markwu123454/Harbinger/README.md

# Harbinger

Harbinger is a coil gun mounted on a differential turret.
