markwu123454/Harbinger/(list of files, cad)

Other CAD files:
cad/turret/0100-v01.SLDASM
cad/turret/0117-v01.SLDPRT
cad/turret/0120-v01.SLDPRT
cad/turret/0125-v01.SLDPRT
cad/turret/Mirror0101-v02.SLDPRT
cad/turret/0101-v02.SLDPRT
cad/turret/Mirror0124-v01.SLDPRT
cad/turret/0121-v01.SLDPRT
cad/turret/0124-v01.SLDPRT
cad/turret/0111-v01.SLDPRT
cad/turret/0109-v01.SLDPRT
cad/turret/0115-v01.SLDPRT
cad/turret/0107-v02.SLDPRT
cad/turret/0116-v01.SLDPRT
cad/turret/0102-v01.SLDPRT
cad/turret/0103-v01.SLDPRT
cad/turret/0105-v01.SLDPRT
cad/turret/0113-v01.SLDPRT
cad/turret/0110-v01.SLDPRT
cad/turret/0106-v01.SLDPRT
cad/turret/0123-v01.SLDPRT
cad/turret/0119-v01.SLDPRT
cad/turret/0114-v01.SLDPRT
cad/turret/0118-v01.SLDPRT
cad/turret/0122-v01.SLDPRT
cad/turret/0104-v02.SLDPRT
cad/turret/0112-v01.SLDPRT
cad/turret/0108-v01.SLDPRT
cad/COTS/220 35V Capacitor, LM2596 Buck Converter 4.0-40 to 1.3-37V.SLDPRT
cad/COTS/3 Digit 7 Segment Display, LM2596 Buck Converter 4.0-40 to 1.3-37V.SLDPRT
cad/COTS/AS5600.SLDPRT
cad/COTS/Base, LM2596 Buck Converter 4.0-40 to 1.3-37V.SLDPRT
cad/COTS/C14 Combo Socket (AC-14-F16).SLDPRT
cad/COTS/DG301-5.0-02, LM2596 Buck Converter 4.0-40 to 1.3-37V.SLDPRT
cad/COTS/EL90002--STD--Tomada de Força (Plug Tripolar Macho - C14 10A).SLDPRT
cad/COTS/ESP32-DEVKITC-32U--3DModel-STEP-418109.SLDPRT
cad/COTS/GM4108Motor_AS5048AEncoder_simplified.SLDPRT
cad/COTS/GM4108Motor_simplified.SLDPRT
cad/COTS/LM2596 Buck Converter 4.0-40 to 1.3-37V.SLDASM
cad/COTS/LRS-150.SLDPRT
cad/COTS/SKF_608-2ZZ.SLDPRT
cad/COTS/SimpleFOC Mini Driver.SLDPRT
cad/COTS/TCA9548.SLDPRT
cad/COTS/Trimpot 3296W, LM2596 Buck Converter 4.0-40 to 1.3-37V.SLDPRT
cad/COTS/diametric small magnet.SLDPRT
cad/COTS/slip ring.SLDPRT
cad/turret/0101-v01.SLDPRT
cad/turret/0104-v01.SLDPRT
cad/turret/0107-v01.SLDPRT
