markwu123454/Harbinger/src/SharedData.cpp

#include "SharedData.h"
#include <stdio.h>

SharedData        shared;
SemaphoreHandle_t dataMutex  = nullptr;
QueueHandle_t     logQueue   = nullptr;

void sharedInit() {
    dataMutex = xSemaphoreCreateMutex();
    logQueue  = xQueueCreate(LOG_QUEUE_DEPTH, sizeof(LogEntry));
}

// ── Log queue ─────────────────────────────────────────────────────

void logWrite(uint8_t level, const char* fmt, ...) {
    if (!logQueue) return;
    LogEntry e{};
    e.level = level;
    va_list args;
    va_start(args, fmt);
    vsnprintf(e.msg, sizeof(e.msg), fmt, args);
    va_end(args);
    // Non-blocking: drop the message if the queue is full rather than stalling a task
    xQueueSendToBack(logQueue, &e, 0);
}

bool logRead(LogEntry& out) {
    if (!logQueue) return false;
    return xQueueReceive(logQueue, &out, 0) == pdTRUE;
}

// ── Motor ↔ Shared ──────────────────────────────────────────────

MotorSnapshot motorRead() {
    MotorSnapshot s{};
    xSemaphoreTake(dataMutex, portMAX_DELAY);
    s.targetHeading   = shared.targetHeading;
    s.targetElevation = shared.targetElevation;
    s.turretArm       = shared.turretArm;
    s.masterArm       = shared.masterArm;
    s.fireRequested   = shared.fireRequested;
    s.gunArm          = shared.gunArm;
    xSemaphoreGive(dataMutex);
    return s;
}

void motorWrite(float heading, float elevation,
                float aVel, float aAcc,
                float bVel, float bAcc) {
    xSemaphoreTake(dataMutex, portMAX_DELAY);
    shared.currentHeading   = heading;
    shared.currentElevation = elevation;
    shared.motorA_vel       = aVel;
    shared.motorA_acc       = aAcc;
    shared.motorB_vel       = bVel;
    shared.motorB_acc       = bAcc;
    shared.fireRequested    = false;
    xSemaphoreGive(dataMutex);
}

void motorSetCalibrated(bool cal) {
    xSemaphoreTake(dataMutex, portMAX_DELAY);
    shared.calibrated = cal;
    xSemaphoreGive(dataMutex);
}

// ── Wifi ↔ Shared ───────────────────────────────────────────────

WifiSnapshot wifiRead() {
    WifiSnapshot s{};
    xSemaphoreTake(dataMutex, portMAX_DELAY);
    s.currentHeading   = shared.currentHeading;
    s.currentElevation = shared.currentElevation;
    s.motorA_vel       = shared.motorA_vel;
    s.motorA_acc       = shared.motorA_acc;
    s.motorB_vel       = shared.motorB_vel;
    s.motorB_acc       = shared.motorB_acc;
    s.masterArm        = shared.masterArm;
    s.turretArm        = shared.turretArm;
    s.gunArm           = shared.gunArm;
    s.targetVoltage    = shared.targetVoltage;
    s.calibrated       = shared.calibrated;
    s.stateChanged     = shared.stateChanged;
    shared.stateChanged = false;
    xSemaphoreGive(dataMutex);
    return s;
}

void wifiWriteAim(float heading, float elevation) {
    xSemaphoreTake(dataMutex, portMAX_DELAY);
    shared.targetHeading   = heading;
    shared.targetElevation = elevation;
    xSemaphoreGive(dataMutex);
}

void wifiWriteArm(int masterArm, int turretArm, int gunArm) {
    xSemaphoreTake(dataMutex, portMAX_DELAY);
    bool changed = false;
    if (masterArm >= 0 && shared.masterArm != (bool)masterArm) { shared.masterArm = masterArm; changed = true; }
    if (turretArm >= 0 && shared.turretArm != (bool)turretArm) { shared.turretArm = turretArm; changed = true; }
    if (gunArm    >= 0 && shared.gunArm    != (bool)gunArm)    { shared.gunArm    = gunArm;    changed = true; }
    if (masterArm == 0 && (shared.turretArm || shared.gunArm)) {
        shared.turretArm = false;
        shared.gunArm    = false;
        changed = true;
    }
    if (changed) shared.stateChanged = true;
    xSemaphoreGive(dataMutex);
}

void wifiWriteVoltage(float v) {
    xSemaphoreTake(dataMutex, portMAX_DELAY);
    shared.targetVoltage = v;
    shared.stateChanged  = true;
    xSemaphoreGive(dataMutex);
}

void wifiWriteFire() {
    xSemaphoreTake(dataMutex, portMAX_DELAY);
    if (shared.gunArm && shared.masterArm)
        shared.fireRequested = true;
    xSemaphoreGive(dataMutex);
}
