markwu123454/Harbinger/(commit log)

2026-04-08 added cad
    [0100-v01.SLDASM, 0101-v01.SLDPRT, 0101-v02.SLDPRT, 0102-v01.SLDPRT, 0103-v01.SLDPRT, 0104-v01.SLDPRT, 0104-v02.SLDPRT, 0105-v01.SLDPRT]
2026-04-08 added electronics mount
    [0100-v01.SLDASM, 0120-v01.SLDPRT, 0121-v01.SLDPRT, TCA9548.SLDPRT]
2026-05-02 Replace WiFi/WebSocket with Bluetooth Classic SPP + binary framed protocol
    Removes the soft-AP hotspot, HTTP server, DNS captive portal, and WebSocket
    in favour of BluetoothSerial (RFCOMM/SPP) on the ESP32. Replaces JSON text
    frames with a tight binary protocol—one type byte followed by a fixed-size
    packed payload—eliminating JSON parsing overhead and cutting per-frame size
    to 1–25 bytes for the high-rate messages.
    New files
    include/proto.h — canonical C++ protocol: type IDs, payload sizes,
    packed structs (PktAim, PktState, PktTelemetry …),
    ARM 2-bit encoding helpers, STATE flag constants.
    include/BtTask.h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
    [BtTask.h, Config.h, main.cpp, proto.h]
2026-05-03 feat: add AS5600 closed-loop position control
    - Add CLOSED_LOOP_POSITION mode using MagneticSensorI2C (SimpleFOC)
    - Init two separate I2C buses so both AS5600s (fixed addr 0x36) coexist
    - Link sensors to motors before initFOC() for auto-calibration
    - applyPIDConfig() wires angle_P / velocity PID / LPF from TurretConfig
    - Add encoder I2C pin fields to TurretPins (sdaA/sclA on bus0, sdaB/sclB on bus1)
    - Add PID gain fields to TurretConfig with tunable defaults
    - controlTask switches to CLOSED_LOOP_POSITION by default
    [Config.h, DifferentialTurret.cpp, DifferentialTurret.h]
2026-05-03 refactor: replace dual I2C buses with TCA9548A multiplexer for AS5600 encoders
    Both AS5600s share address 0x36 and now live on a single I2C bus behind
    a TCA9548A mux. MuxedMagneticSensorI2C selects the right channel before
    every getSensorAngle() call, so SimpleFOC needs no other changes.
    [Config.h, DifferentialTurret.cpp, DifferentialTurret.h, MuxedMagneticSensor.h, TCA9548A.h]
2026-05-09 Always track sensors + send full state dump on connect
    - DifferentialTurret::begin(): explicitly call motor.enable() after initFOC()
    so motor.enabled stays true permanently. DifferentialTurret::disable() only
    kills the driver hardware (no current), leaving loopFOC() running so the
    AS5600 sensors are always read — manual spinning while disarmed is now tracked.
    - BtTask: on client connect, send MSG_TELEMETRY immediately after MSG_STATE so
    the app gets current position/vel/accel without waiting for the first heartbeat.
    - Telemetry interval: 250ms → 50ms (20 Hz) for smoother live tracking.
2026-05-09 Bump telemetry to 100 Hz; batch type+payload into single BT write
    - Telemetry interval: 50ms -> 10ms (100 Hz), matching the control loop rate.
    Sending faster than 10ms would just re-transmit stale sensor values since
    motorWrite() only runs every 10ms in the control task.
    - sendRaw(): coalesce type byte and payload into a single bt_.write() call.
    At 100 Hz (200 write() calls/sec previously), the double round-trip through
    BluetoothSerial's TX queue added unnecessary overhead.
2026-05-09 Add MSG_LOG: remote string logging from any firmware task
    - proto.h: MSG_LOG=0x85, LOG_INFO/WARN/ERROR levels, PSIZ_LOG_HEADER=2
    - SharedData: FreeRTOS queue (depth 8) + logWrite(level, fmt, ...) / logRead()
    so ControlTask, DifferentialTurret, etc. can post messages without touching BT
    - BtTask: drain log queue immediately on connect (captures startup/initFOC logs)
    and on every subsequent loop iteration
    - DifferentialTurret::begin(): log initFOC() return value and post-calibration
    shaft_angle for both motors — dead/misread encoders show up immediately
    [BtTask.h, DifferentialTurret.cpp, SharedData.cpp, SharedData.h, proto.h]
2026-05-22 Fix encoder error messages never reaching the app
    setup() manually created dataMutex but never called sharedInit(), so
    logQueue remained nullptr. Every logWrite() guards with
    if (!logQueue) return, silently dropping all encoder init errors
    (sensor angle 0.0 warnings, initFOC failure errors) before they could
    be queued and forwarded to the app via MSG_LOG.
    Replace manual xSemaphoreCreateMutex() with sharedInit(), which
    creates both dataMutex and logQueue as documented in SharedData.h.
    https://claude.ai/code/session_01FsLupdy2irwsaDZRn6RpLY
    [main.cpp]
2026-05-22 Fix initFOC failure by setting voltage_sensor_align
    initFOC() physically rotates each motor during calibration to find the
    electrical zero angle. voltage_sensor_align controls how much voltage is
    applied during that sequence; it defaults to voltage_limit (3 V here),
    which at 3V / 11.1Ohm = ~0.27 A is not enough to overcome motor cogging
    torque and move the rotor.
    Add sensor_align_voltage to TurretConfig (default 6 V) and assign it to
    motor.voltage_sensor_align before calling initFOC() on each motor. The
    runtime voltage_limit of 3 V is unaffected — alignment is a one-shot
    event at startup.
    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
    [Config.h, DifferentialTurret.cpp, DifferentialTurret.h]
2026-05-22 Fix mux channel not selected during initFOC, use angle mode for calibration
    Two bugs causing initFOC to always fail:
    1. MuxedMagneticSensorI2C only overrode getSensorAngle(), but
    MagneticSensorI2C::update() (called by motor.init() and initFOC()
    internally) calls the raw I2C read directly without going through
    getSensorAngle(). The mux channel was therefore never selected during
    sensor updates triggered by the FOC stack, so each motor read from
    whichever channel the mux last happened to be on. Override update() so
    the channel is selected regardless of which code path triggers the read.
    2. begin() initialised both motors with velocity_openloop before calling
    initFOC(). I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
    [DifferentialTurret.cpp, MuxedMagneticSensor.h]
2026-05-22 Add verbose initFOC diagnostics and enable SimpleFOC serial debug
    - Enable SimpleFOCDebug::enable(&Serial) so SimpleFOC's own alignment
    trace (sensor movement, direction check, voltage steps) appears in
    the serial monitor.
    - Check and log driver.init() return values.
    - Check and log motor.init() return values.
    - Read the sensor through update() (not getSensorAngle()) immediately
    before initFOC to confirm the mux override fix is working — if this
    reads 0 the mux channel is still wrong; if it reads a valid angle
    the sensor path is good and the failure is in the alignment sequence.
    - Log zero_electric_angle after initFOC (even on failure) to show
    whether SimpleFOC ran any calibrat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
    [DifferentialTurret.cpp]
2026-05-22 Send driver/motor init results over BT log instead of Serial-only
    zero_electric_angle=-12345 (NOT_SET) proves initFOC() bails before the
    alignment sequence because motor_status==motor_unconfigured, which means
    motor.init() failed (likely because driver.init() failed beneath it).
    Move driver and motor init pass/fail messages into the BT log queue so
    the root cause is visible in the app without a serial monitor.
    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
    [DifferentialTurret.cpp]
2026-05-22 Enable motor driver before initFOC so alignment can physically move the rotor
    BLDCDriver3PWM::init() configures the enable pin as OUTPUT but leaves it
    LOW (driver disabled). initFOC()/alignSensor() was called while the driver
    was still off: PWM signals were applied but the enable pin was LOW so the
    motor driver IC produced no current, the rotor couldn't move, alignSensor()
    detected zero movement and returned 0 immediately, leaving
    zero_electric_angle at NOT_SET (-12345).
    Move motor.enable() to before initFOC() so the driver is live during the
    alignment sequence. The control task immediately calls turret.disable()
    on its first iteration (nothing armed at startup), so the driver is safely
    sil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
2026-05-22 Disable Motor A driver during Motor B initFOC alignment
    Motor A's alignment sequence physically moves the differential turret.
    When Motor B runs its alignment immediately after, Motor A's cogging
    resists movement through the coupled mechanism, keeping total movement
    below MIN_ANGLE_DETECT_MOVEMENT so alignSensor() returns 0 without
    setting zero_electric_angle.
    Fix: call _driverA->disable() after Motor A's initFOC and
    _driverA->enable() after Motor B's initFOC. This drives Motor A's
    enable pin low during Motor B's alignment so the driver IC produces
    no holding torque. The motor object stays enabled (motor.enabled=true)
    so loopFOC() works correctly once the control loop starts.
    https://claud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
    [DifferentialTurret.cpp]
2026-05-22 Fix per-motor acceleration: use d(shaft_velocity)/dt not velocity error
    The acc field in telemetry was sending shaft_velocity_sp - shaft_velocity
    (the velocity loop error), not actual acceleration. Add per-motor
    acceleration tracking in DifferentialTurret::update() by differentiating
    shaft_velocity against a microsecond timestamp each cycle.
    Heading/elevation for the aim pad remain differential (unchanged).
    The motor bars show individual motor vel and acc as they should.
    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
    [DifferentialTurret.cpp, DifferentialTurret.h]
2026-05-22 Fix initFOC alignment voltage clamping
    setPhaseVoltage() clamps Uq to voltage_limit, so sensor_align_voltage=6V
    had no effect when voltage_limit=3V. Temporarily raise voltage_limit to
    sensor_align_voltage before each initFOC() call and restore it after,
    ensuring alignSensor() can actually move the rotor.
    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
    [DifferentialTurret.cpp]
2026-05-25 fix: enable motor drivers before initFOC so alignment can physically rotate motors
    SimpleFOC 2.4.0 changed BLDCMotor::init() to no longer call enable()
    internally (it did in 2.3.x). With the gate driver enable pin staying LOW,
    alignSensor() sends PWM commands that the gate driver ignores, the motor
    never rotates, SimpleFOC detects no sensor movement, and returns 0
    (failure) leaving zero_electric_angle at the NOT_SET sentinel (-12345).
    Fix: call motor.enable() before initFOC() for both motors so the gate
    driver is active during the alignment sweep.
    Also convert driver/motor init Serial.printf calls to logWrite() so these
    diagnostics appear in the BT log and are visible in the app.
    [DifferentialTurret.cpp]
2026-05-25 Add NVS calibration store; fix Motor B voltage_limit; graceful FOC failure handling
    - New CalibrationStore (ESP32 Preferences) persists zero_electric_angle and
    sensor_direction for both motors after a successful live alignment. On
    subsequent boots the stored values are supplied directly to initFOC(),
    bypassing the physical alignment sweep that requires 24 V motor power.
    - Fix: Motor B's voltage_limit was never restored to config.voltage_limit
    after initFOC() — it was left at sensor_align_voltage (6 V) for the
    entire runtime.
    - If initFOC fails for either motor (no stored cal AND no 24 V present),
    both drivers are disabled and _calibrated is set false so the control
    loop does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
    [BtTask.h, Calibration.cpp, Calibration.h, DifferentialTurret.cpp, DifferentialTurret.h, SharedData.cpp, SharedData.h, proto.h]
2026-05-25 Fix build errors: add proto.h include; adapt to SimpleFOC 2.4 initFOC() signature
    SimpleFOC 2.4 removed the (float, Direction) overload of initFOC().
    To bypass live alignment with stored calibration values, pre-set
    motor.zero_electric_angle and motor.sensor_direction directly before
    calling the zero-argument initFOC(); SimpleFOC skips alignSensor()
    whenever zero_electric_angle != NOT_SET (-12345).
    Also add #include "proto.h" so LOG_INFO/LOG_WARN/LOG_ERROR are in scope.
    [DifferentialTurret.cpp]
2026-05-25 Add pre-alignment motor self-test; auto-detect active-LOW enable polarity
    Before each initFOC() call, apply a static phase voltage for 800ms and
    read the sensor angle delta via logWrite(). This surfaces in the BT app
    log, giving a clear MOVED / NOT-MOVED result for each motor.
    If NOT-MOVED, the code automatically flips enable_active_high to LOW on
    the driver (active-LOW gate driver) and retries once. If that also fails
    it restores the original polarity and the NOT-MOVED log line tells the
    operator to check wiring / 24V.
    Also fix an incorrect code comment: SimpleFOC 2.4 BLDCMotor::init() DOES
    call enable() internally at the end of init(), so our explicit enable()
    call is redundant (harmle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
    [DifferentialTurret.cpp]
2026-05-25 refactor: extract initOneMotor(), unify logging, rename cpp files to PascalCase
    - DifferentialTurret: pull Motor A/B init into initOneMotor() helper;
    begin() drops from ~200 to ~60 lines with no behaviour change
    - Remove verbose Serial.printf throughout DifferentialTurret.cpp;
    use logWrite consistently so all diagnostics flow through the BT log queue
    - Remove noisy per-call prints from setTarget/mixAndApply (100 Hz flood)
    - Fix stray leading space before PSIZ_PING in proto.h
    - Rename btTask.cpp → BtTask.cpp and controlTask.cpp → ControlTask.cpp
    to match the PascalCase headers they implement
    [BtTask.cpp, ControlTask.cpp, DifferentialTurret.cpp, DifferentialTurret.h, proto.h]
2026-05-25 fix: restore enable pin after failed polarity flip; add verbose init logging
    Bug: in initOneMotor(), when the active-LOW retry fails and
    enable_active_high is restored to HIGH, driver->enable() was never
    called. The GPIO was left LOW (state from the retry's driver->enable()
    with active_high=LOW), so initFOC() ran with the gate driver disabled —
    guaranteed failure even with 24V present.
    Fix: call driver->enable() after restoring enable_active_high = HIGH.
    Also:
    - Log GPIO pin state (digitalRead) before and after every enable/disable
    call so the app log shows exactly what the pin is doing at each step
    - Log ang_before and ang_after separately (not just delta) so we can see
    if the senso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
    [DifferentialTurret.cpp]
2026-05-25 fix: remove self-test, increase align voltage, disable both drivers before each initFOC
    Root cause identified from logs: the static single-angle self-test cannot
    move a spring-coupled differential mechanism at 6V (motor reaches force
    balance and springs back when released, giving delta=0.0000). The
    initFOC sweep DOES physically rotate the motor (user confirmed) but by
    less than SimpleFOC's MIN_ANGLE_DETECT_MOVEMENT threshold because:
    - 6V only gives ~0.54A through 11.1 Ohm => insufficient torque through
    the gear train to achieve the required >0.5 rad rotation
    - Driver B was still active during Motor A's initFOC, adding coupling
    resistance through the differential linkage
    Changes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
    [Config.h, DifferentialTurret.cpp, SharedData.h]
2026-05-25 fix: set voltage_sensor_align after motor.init(); add sensor updates when uncalibrated
    Bug: motor.init() resets voltage_sensor_align back to voltage_limit (3V)
    internally. We were setting it to alignVoltage (12V) before init(), which
    init() then overwrote. initFOC was running the alignment sweep at 3V not
    12V — same insufficient torque as before despite the config change.
    Fix: move voltage_sensor_align = alignVoltage assignment to immediately
    before motor.initFOC() (alongside the voltage_limit raise), after
    motor.init() can no longer clobber it.
    Also: update sensors in the uncalibrated path of update() so
    shaft_velocity and shaft_angle are live even when FOC calibration has
    failed. The e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
    [DifferentialTurret.cpp]
2026-05-25 feat: add AS5600 magnet health check on startup (STATUS/AGC/MAGNITUDE)
    Add logAS5600Health() which reads three AS5600 registers directly over
    I2C (with mux channel selected first) and logs a clear go/no-go on
    magnet placement for each sensor:
    STATUS 0x0B - MD(bit3)=detected ML(bit4)=too weak MH(bit5)=too strong
    AGC 0x1A - 0=saturated/too close 255=nothing/too far ~80-180=good
    MAGNITUDE 0x1B-0x1C - 12-bit field strength cross-check
    Called for both sensors immediately after sensor init, before motor init,
    so the first thing visible in the app log is a clear diagnostic:
    [LOG] SensorA AS5600: status=0x28 md=1 mh=0 ml=0 agc=142/255 magnitude=2341/4095 [magnet OK]
    [ERR] S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
    [DifferentialTurret.cpp]
2026-05-25 fix: hold brake motor at DC voltage during partner's FOC alignment sweep
    Root cause identified from logs: the differential coupling was absorbing
    all alignment torque. When Motor A's coils were energized during initFOC,
    Motor A's rotor snapped to a detent and held still while Motor B (the free
    end of the coupled mechanism) rotated instead. Motor A's sensor therefore
    read rawDelta=0.0000 throughout, so SimpleFOC never detected movement.
    Evidence: Motor B's pre-initFOC sensor angle (2.6246 rad) differed from its
    initial read (2.3577 rad), confirming Motor B moved during Motor A's alignment.
    Fix: refactor initOneMotor() → setupMotor() + alignMotor(). Setup is now
    called for BOTH motors fir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
    [DifferentialTurret.cpp, DifferentialTurret.h]
2026-05-25 fix: swap mux chanA/chanB — sensors were assigned to wrong motors
    Root cause: channel 0 physically wires to Motor B's AS5600 and channel 1
    wires to Motor A's. The swapped assignment caused initFOC to read the
    stationary motor's encoder during the active motor's alignment sweep,
    producing rawDelta=0.000 on every attempt.
    Evidence (from log, with differential mechanism removed and motors untouched):
    - Motor B's sensor angle changed 2.3577→2.6246 rad DURING Motor A's initFOC,
    which is only possible if sensorB was reading Motor A's physical encoder.
    - sensorA showed rawDelta=0 during Motor A's sweep (reading Motor B's encoder).
    Secondary: channel 0 has agc=15 (magnet too close to chip, M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
    [Config.h]
2026-05-26 fix: default to open-loop velocity mode to prevent PID jitter on enable
    CLOSED_LOOP_POSITION with untuned gains caused motors to oscillate immediately
    on enable as they tried to hold position 0. VELOCITY (open-loop) lets the
    joystick command motor speed directly without needing PID tuning first.
    https://claude.ai/code/session_01KnyYgodQv62UeQ1h292QNv
    [ControlTask.cpp]
2026-05-26 tune: conservative PID starting values; restore closed-loop position mode
    Jitter with previous gains (angle_P=20, velocity_I=10) was caused by:
    - Outer position P too large: 0.05 rad error → 1 rad/s velocity command, too aggressive
    - velocity_I=10 winds up rapidly at 10ms loop period, causing overshoot-undershoot cycle
    - velocity_lpf=0.01s too short for noisy encoder (especially Motor B at agc≈15)
    New starting values estimated from oscillation behavior:
    angle_P 20→5, velocity_I 10→5, velocity_ramp 1000→500, velocity_lpf 0.01→0.05
    Tuning order: angle_P first (raise until responsive), then velocity_P,
    then add velocity_I last to remove steady-state drag.
    https://claude.ai/code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
    [Config.h, ControlTask.cpp]
2026-05-26 feat: synchronize motor velocities for straight-line heading/elevation motion
    Without this, heading (gear 6:1) and elevation (gear ~0.82:1) motors travel
    different distances at the same velocity limit, so the faster axis finishes
    first and the trajectory curves — moving horizontally then zipping vertically.
    Fix: each loop cycle, scale each motor's velocity_limit proportional to its
    remaining distance. The motor with the longer path gets full velocity_limit;
    the other is throttled by the ratio (errShort/errLong), so both arrive at
    their targets simultaneously and the output path stays straight.
    A 5% floor prevents the leading motor dropping to zero and losing position-
    correction authorit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
    [DifferentialTurret.cpp]
